wsun26/ece445/CAD/Capture.PNG

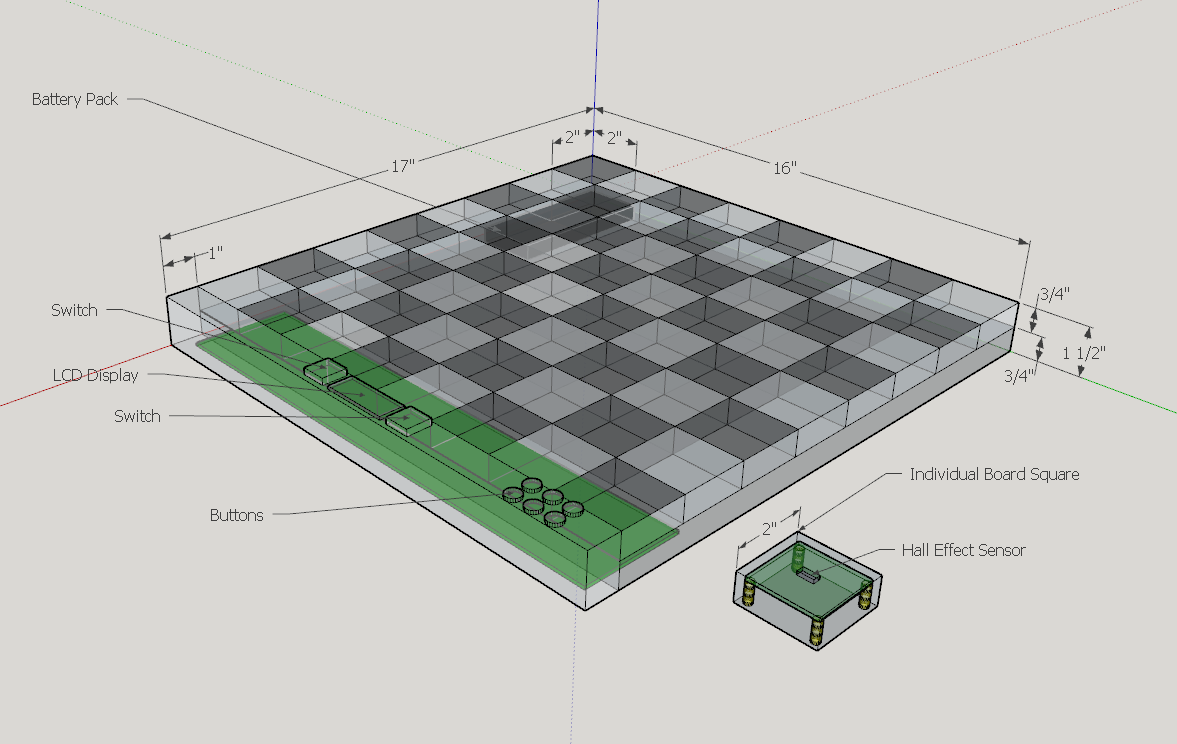
CAD/Capture.PNG
