wsun26/ece445/CAD/chess_board.PNG

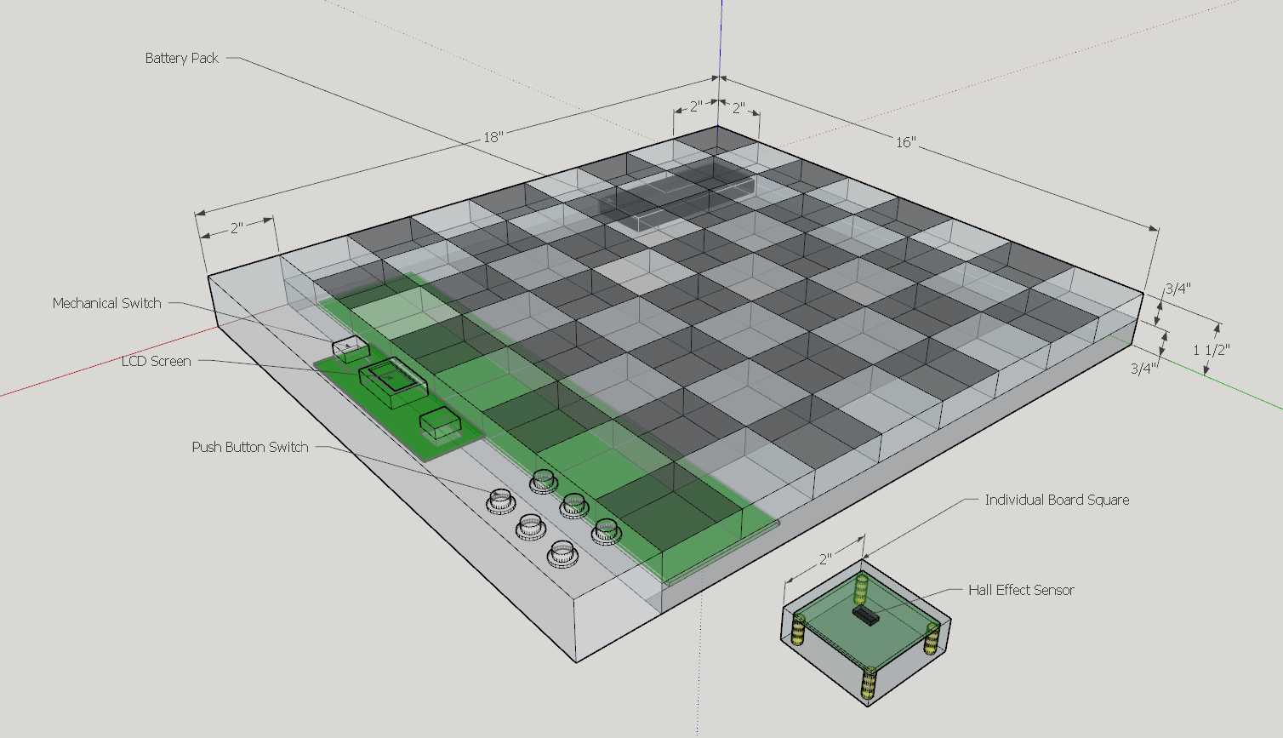
CAD/chess_board.PNG
