wsun26/ece445/CAD/chess_piece_overview.PNG

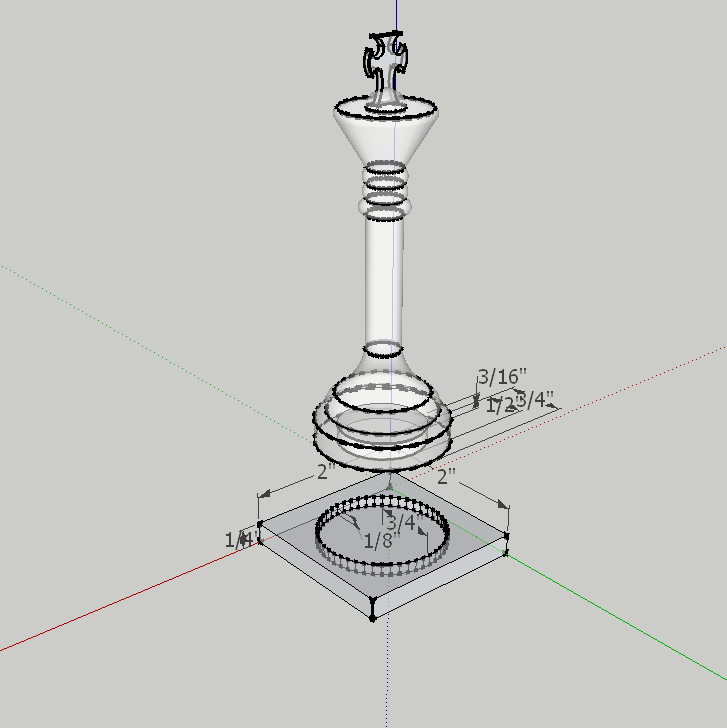
CAD/chess_piece_overview.PNG
