wsun26/ece445/CAD/chess_UI.PNG

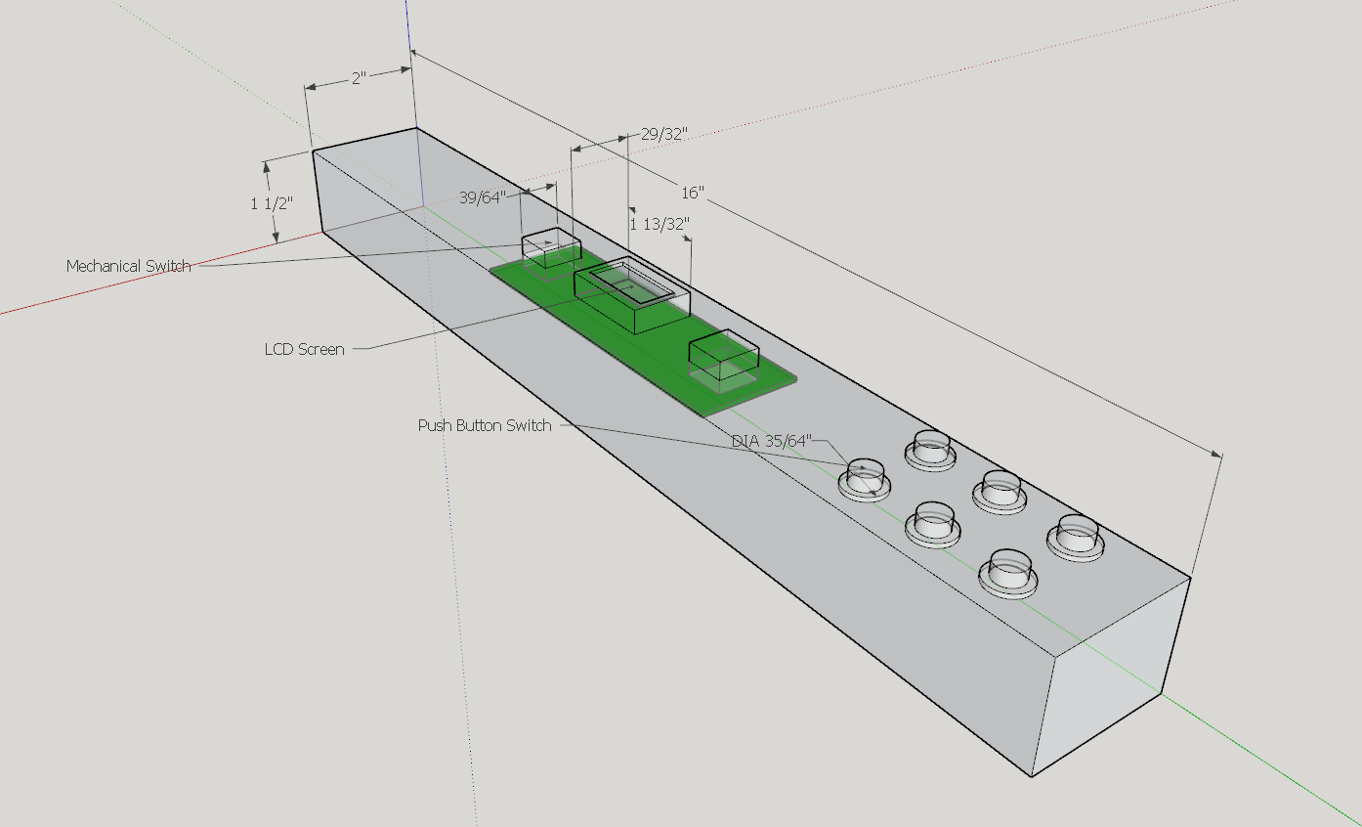
CAD/chess_UI.PNG
