wsun26/ece445/cost_analysis.xlsx

 | prototype (price per item) | Quantity used | prototype (total cost) | bulk (price per item) | bulk (total cost)
Body | 20 | 1 | 20 | 5 | 5
Battery (2.6 Ah 3.7V Li-ion) | 5.95 | 2 | 11.9 | 5.95 | 11.9
Magnet (N42 1"x1/32") | 0.58 | 74 | 42.92 | 0.48 | 35.52
Battery Management IC (MCP-73831T-2ACIOT) | 0.6 | 1 | 0.6 | 0.42 | 0.42
LDO Voltage Regulator (TPS75533KTTT) | 6.1 | 1 | 6.1 | 3.2 | 3.2
Momentary Push Button | 0.536 | 6 | 3.216 | 0.536 | 3.216
Mechanical Switch | 1 | 2 | 2 | 0.5 | 1
8-bit SR (Mouser; SN74HC164NSR) | 0.39 | 24 | 9.36 | 0.108 | 2.592
Demultiplexer (MC74HC238ADR2G) | 0.281 | 1 | 0.281 | 0.078 | 0.078
Bronze Acrylic (1/8") | 0.098 | 32 | 3.136 | 0.098 | 3.136
White Acrylic (1/8") | 0.093 | 32 | 2.976 | 0.093 | 2.976
LCD Display (0208AZ-FSW-GBW-33V3) | 9.8 | 1 | 9.8 | 7.056 | 7.056
Bluetooth Module (HC-06) | 8.99 | 1 | 8.99 | 8.99 | 8.99
Microcontroller (MSP430FR5962IZVWR) | 6.23 | 1 | 6.23 | 3.4 | 3.4
ADC (MAX11603EEE+) | 1.73 | 8 | 13.84 | 1.63 | 13.04
LED (5mm RGB 4 pin) | 0.0896 | 64 | 5.7344 | 0.0896 | 5.7344
Hall Effect Sensor (DRV5053VAQDBZR) | 0.736 | 64 | 47.104 | 0.349 | 22.336
PCB (1"x1" single layer) | 0.24 | 64 | 15.36 | 0.0435 | 2.784
PCB (4"x4" two layer) | 5.6 | 1 | 5.6 | 0.865 | 0.865
Chess Set (1 1/4" base) | 5 | 1 | 5 | 5 | 5
Total |  |  | 220.1474 |  | 138.2434
