wsun26/ece445/(list of files, cad)

Other CAD files:
CAD/UI_layout.skp
CAD/attempt_1.skp
CAD/board_sketchup.skp
CAD/king.skp
