wsun26/ece445/CAD/chess_piece_measurement.PNG

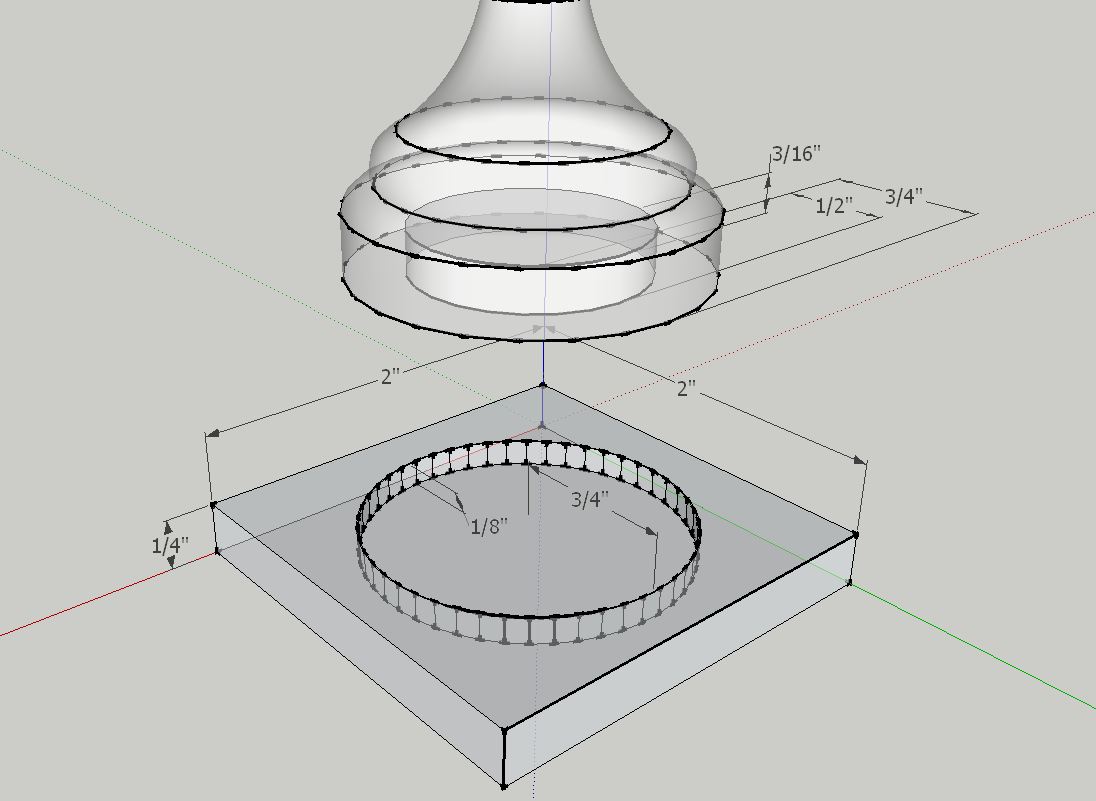
CAD/chess_piece_measurement.PNG
