wsun26/ece445/CAD/chess_piece_measurement_with_sensor.PNG

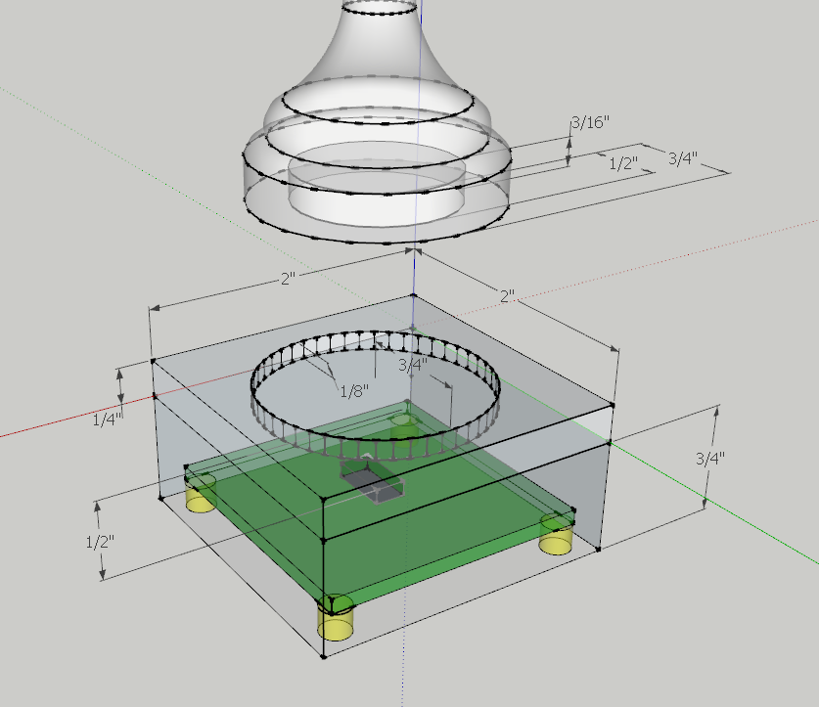
CAD/chess_piece_measurement_with_sensor.PNG
