wsun26/ece445/sensor_board/SensorInterface.brd

## EAGLE design sensor_board/SensorInterface.brd (2019-05-03)

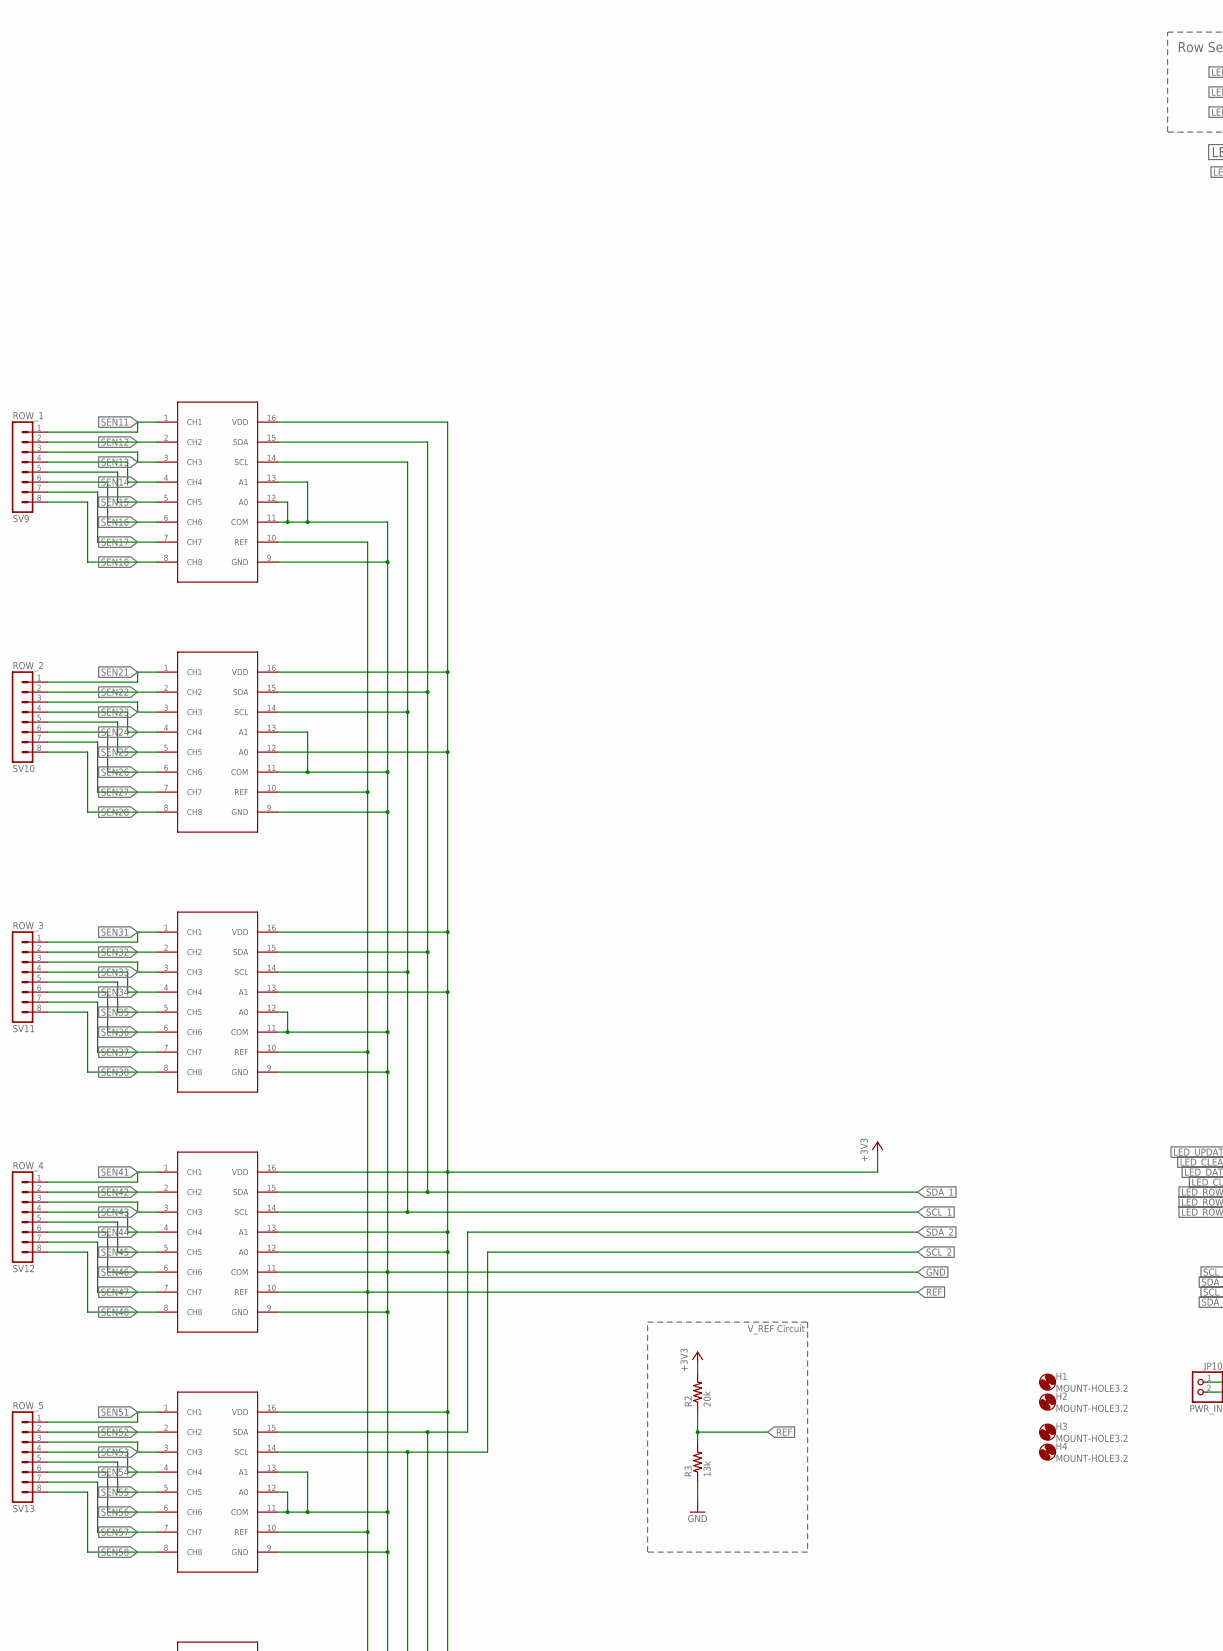
[picture p7: schematic SensorInterface.sch, part in row 1, column 1]

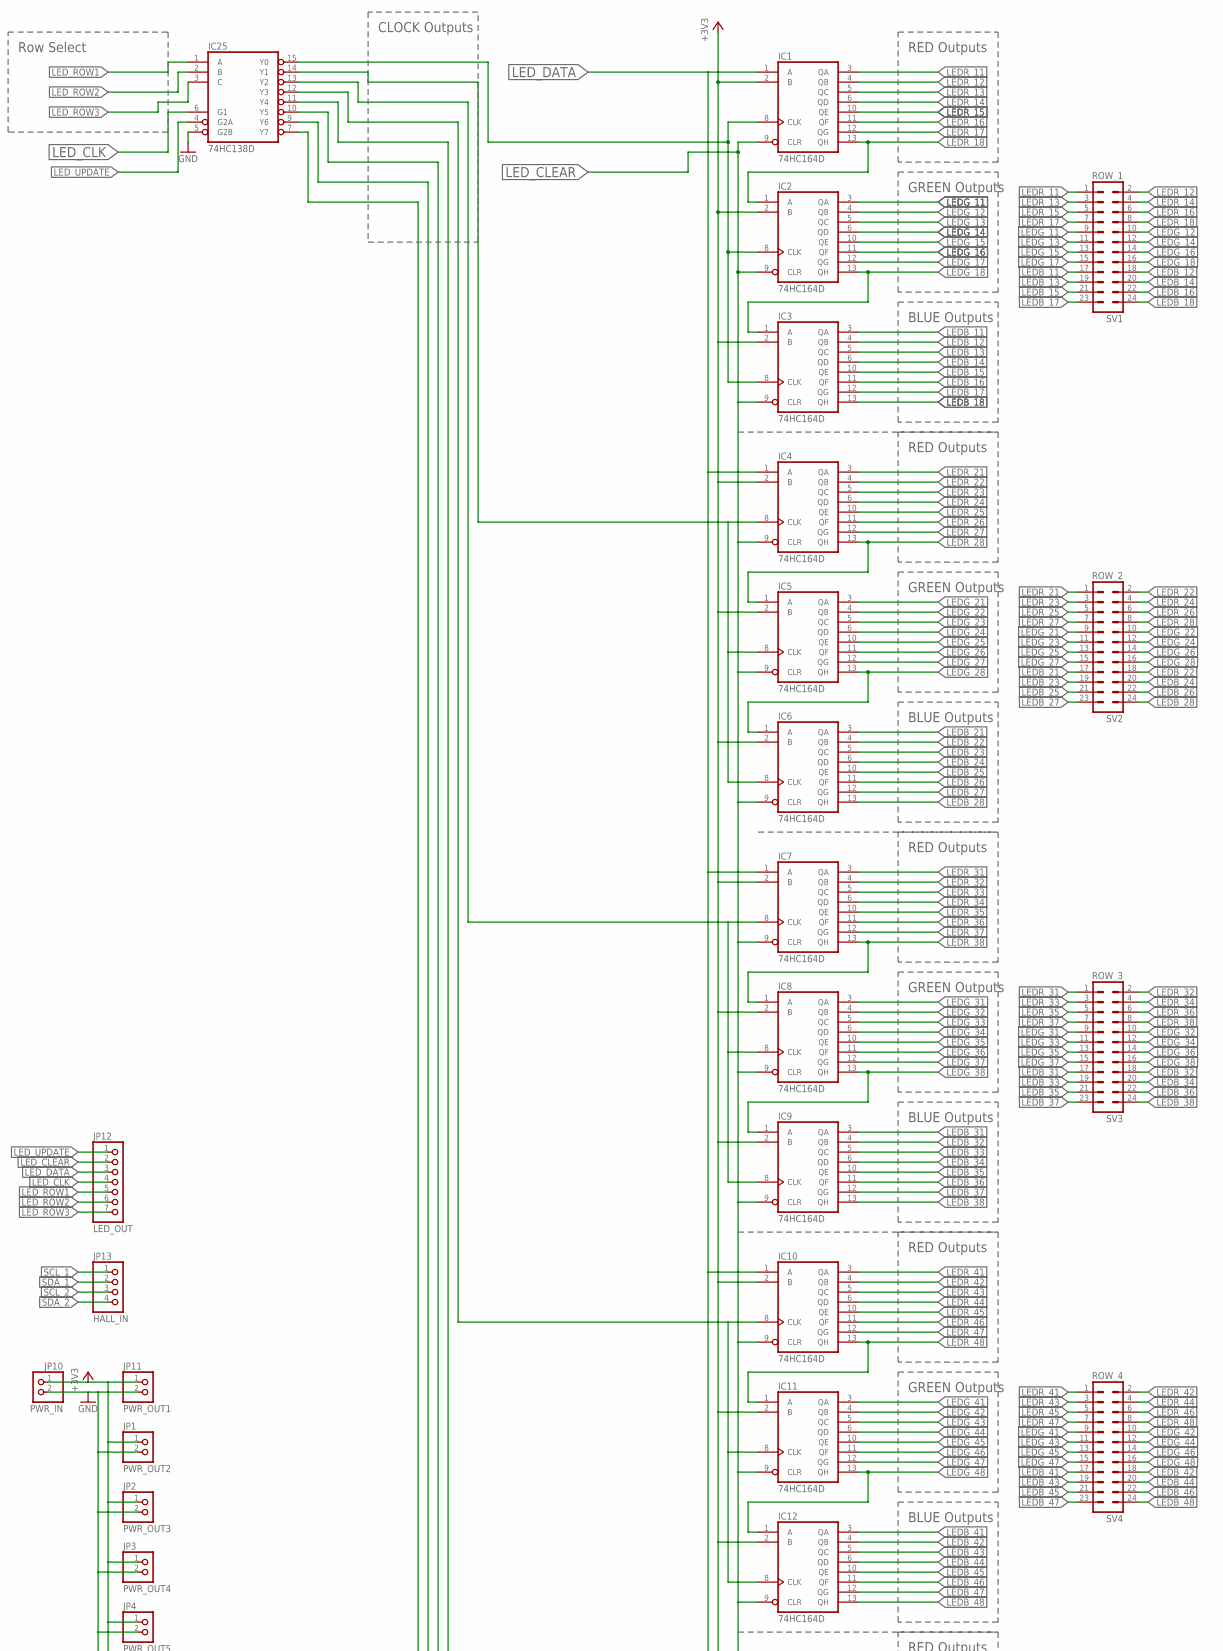
[picture p8: schematic SensorInterface.sch, part in row 1, column 2]

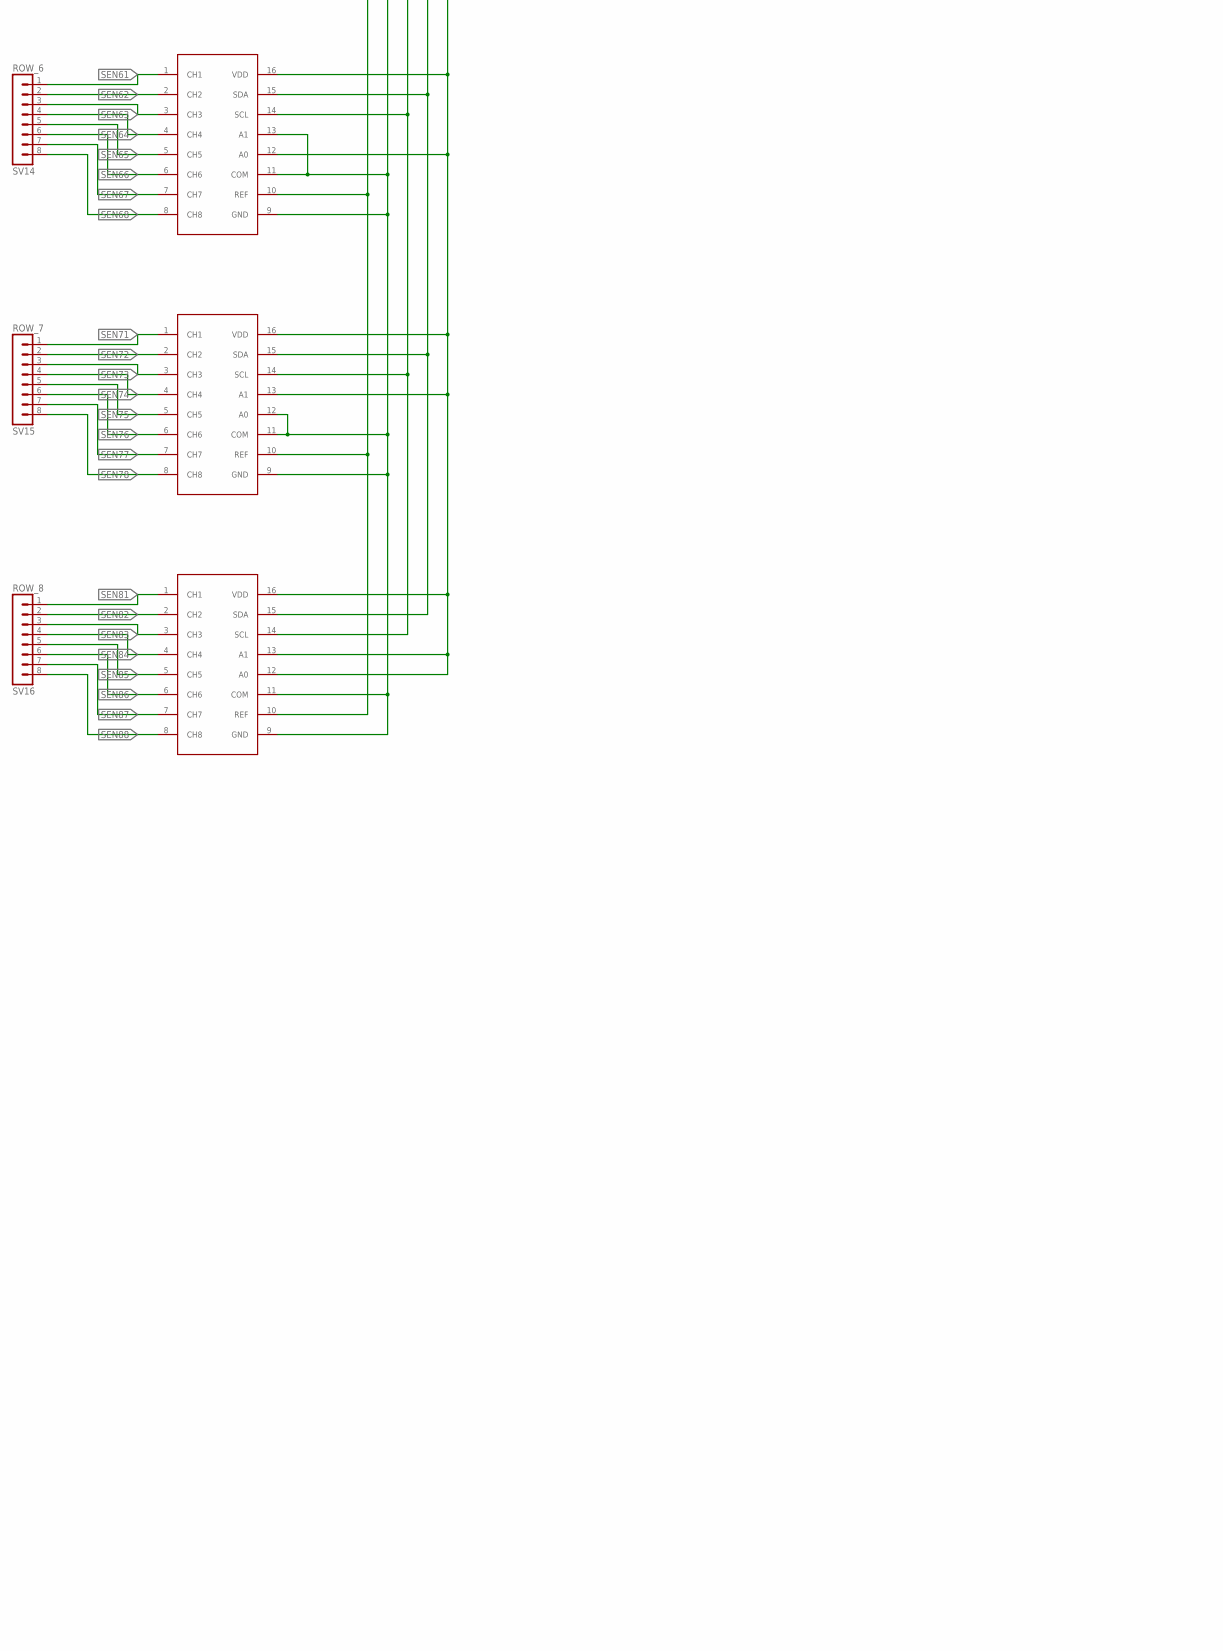
[picture p9: schematic SensorInterface.sch, part in row 2, column 1]

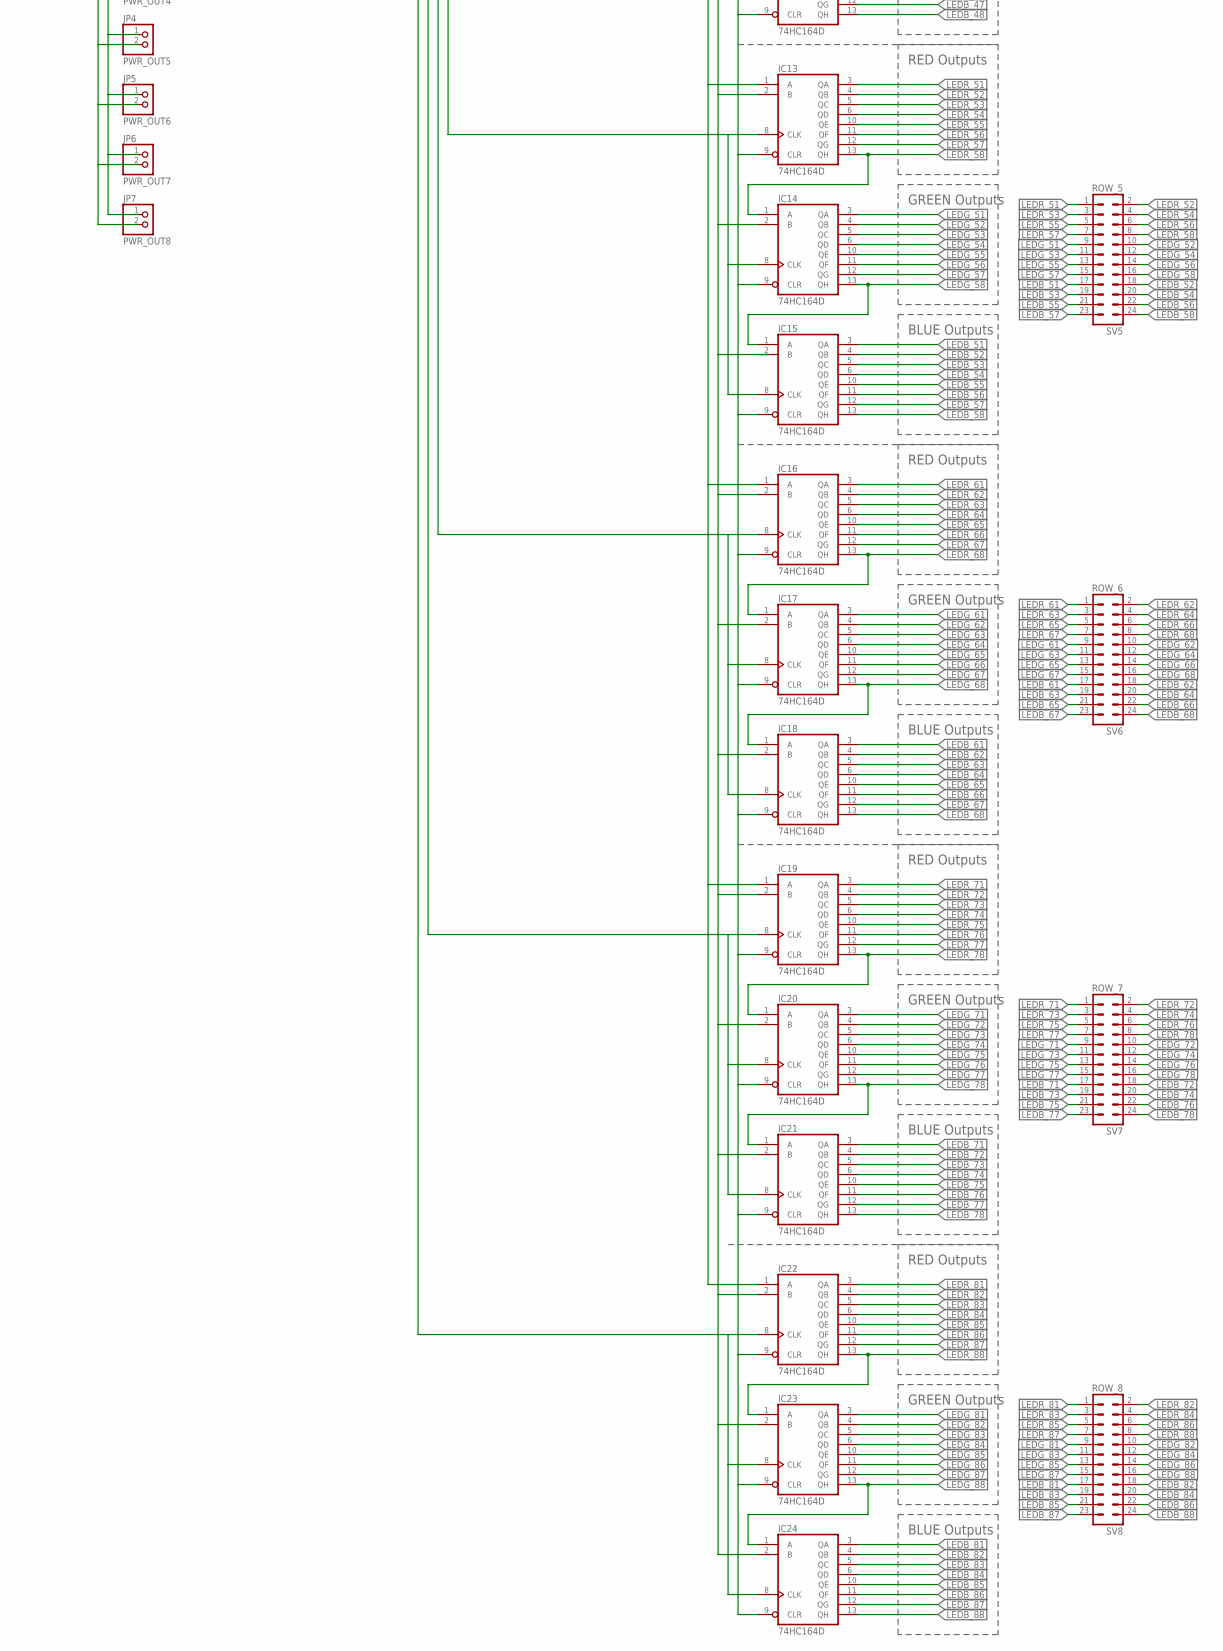
[picture p10: schematic SensorInterface.sch, part in row 2, column 2]

Parts:
H1, H2, H3, H4: MOUNT-HOLE3.2; 3,2
IC1, IC2, IC3, IC4, IC5, IC6, IC7, IC8, IC9, IC10, IC11, IC12, IC13, IC14, IC15, IC16, IC17, IC18, IC19, IC20, IC21, IC22, IC23, IC24: 74HC164D; SO14
IC25: 74HC138D; SO16
JP1: PWR_OUT2; 1X02
JP2: PWR_OUT3; 1X02
JP3: PWR_OUT4; 1X02
JP4: PWR_OUT5; 1X02
JP5: PWR_OUT6; 1X02
JP6: PWR_OUT7; 1X02
JP7: PWR_OUT8; 1X02
JP10: PWR_IN; 1X02
JP11: PWR_OUT1; 1X02
JP12: LED_OUT; 1X07
JP13: HALL_IN; 1X04
R2: 20k; R0603
R3: 13k; R0603
SV1: ROW_1; MA12-2
SV2: ROW_2; MA12-2
SV3: ROW_3; MA12-2
SV4: ROW_4; MA12-2
SV5: ROW_5; MA12-2
SV6: ROW_6; MA12-2
SV7: ROW_7; MA12-2
SV8: ROW_8; MA12-2
SV9: ROW_1; MA08-1
SV10: ROW_2; MA08-1
SV11: ROW_3; MA08-1
SV12: ROW_4; MA08-1
SV13: ROW_5; MA08-1
SV14: ROW_6; MA08-1
SV15: ROW_7; MA08-1
SV16: ROW_8; MA08-1
U$1, U$2, U$3, U$4, U$5, U$6, U$7, U$8: NCD9830; TSSOP16

Connections:
+3V3: IC1.2 (B), IC2.2 (B), IC3.2 (B), IC4.2 (B), IC5.2 (B), IC6.2 (B), IC7.2 (B), IC8.2 (B), IC9.2 (B), IC10.2 (B), IC11.2 (B), IC12.2 (B), IC13.2 (B), IC14.2 (B), IC16.2 (B), IC17.2 (B), IC18.2 (B), IC19.2 (B), IC20.2 (B), IC21.2 (B), IC22.2 (B), IC23.2 (B), IC24.2 (B), JP1.1, JP2.1, JP3.1, JP4.1, JP5.1, JP6.1, JP7.1, JP10.1, JP11.1, R2.2, U$1.12 (A0), U$1.16 (VDD), U$2.13 (A1), U$2.16 (VDD), U$3.12 (A0), U$3.13 (A1), U$3.16 (VDD), U$4.16 (VDD), U$5.12 (A0), U$5.16 (VDD), U$6.13 (A1), U$6.16 (VDD), U$7.16 (VDD), U$8.12 (A0), U$8.13 (A1), U$8.16 (VDD)
CLK: IC19.8 (CLK), IC20.8 (CLK), IC21.8 (CLK), IC25.9 (Y6)
GND: IC1.7 (GND), IC2.7 (GND), IC3.7 (GND), IC4.7 (GND), IC5.7 (GND), IC6.7 (GND), IC7.7 (GND), IC8.7 (GND), IC9.7 (GND), IC10.7 (GND), IC11.7 (GND), IC12.7 (GND), IC13.7 (GND), IC14.7 (GND), IC15.7 (GND), IC16.7 (GND), IC17.7 (GND), IC18.7 (GND), IC19.7 (GND), IC20.7 (GND), IC21.7 (GND), IC22.7 (GND), IC23.7 (GND), IC24.7 (GND), IC25.5 (G2B), IC25.8 (GND), JP1.2, JP2.2, JP3.2, JP4.2, JP5.2, JP6.2, JP7.2, JP10.2, JP11.2, R3.1, U$1.9 (GND), U$1.11 (COM), U$1.13 (A1), U$2.9 (GND), U$2.11 (COM), U$2.12 (A0), U$3.9 (GND), U$3.11 (COM), U$4.9 (GND), U$4.11 (COM), U$4.12 (A0), U$4.13 (A1), U$5.9 (GND), U$5.11 (COM), U$5.13 (A1), U$6.9 (GND), U$6.11 (COM), U$6.12 (A0), U$7.9 (GND), U$7.11 (COM), U$7.12 (A0), U$7.13 (A1), U$8.9 (GND), U$8.11 (COM)
LEDB_11: IC3.3 (QA), SV1.17
LEDB_12: IC3.4 (QB), SV1.18
LEDB_13: IC3.5 (QC), SV1.19
LEDB_14: IC3.6 (QD), SV1.20
LEDB_15: IC3.10 (QE), SV1.21
LEDB_16: IC3.11 (QF), SV1.22
LEDB_17: IC3.12 (QG), SV1.23
LEDB_18: IC3.13 (QH), SV1.24
LEDB_21: IC6.3 (QA), SV2.17
LEDB_22: IC6.4 (QB), SV2.18
LEDB_23: IC6.5 (QC), SV2.19
LEDB_24: IC6.6 (QD), SV2.20
LEDB_25: IC6.10 (QE), SV2.21
LEDB_26: IC6.11 (QF), SV2.22
LEDB_27: IC6.12 (QG), SV2.23
LEDB_28: IC6.13 (QH), SV2.24
LEDB_31: IC9.3 (QA), SV3.17
LEDB_32: IC9.4 (QB), SV3.18
LEDB_33: IC9.5 (QC), SV3.19
LEDB_34: IC9.6 (QD), SV3.20
LEDB_35: IC9.10 (QE), SV3.21
LEDB_36: IC9.11 (QF), SV3.22
LEDB_37: IC9.12 (QG), SV3.23
LEDB_38: IC9.13 (QH), SV3.24
LEDB_41: IC12.3 (QA), SV4.17
LEDB_42: IC12.4 (QB), SV4.18
LEDB_43: IC12.5 (QC), SV4.19
LEDB_44: IC12.6 (QD), SV4.20
LEDB_45: IC12.10 (QE), SV4.21
LEDB_46: IC12.11 (QF), SV4.22
LEDB_47: IC12.12 (QG), SV4.23
LEDB_48: IC12.13 (QH), SV4.24
LEDB_51: IC15.3 (QA), SV5.17
LEDB_52: IC15.4 (QB), SV5.18
LEDB_53: IC15.5 (QC), SV5.19
LEDB_54: IC15.6 (QD), SV5.20
LEDB_55: IC15.10 (QE), SV5.21
LEDB_56: IC15.11 (QF), SV5.22
LEDB_57: IC15.12 (QG), SV5.23
LEDB_58: IC15.13 (QH), SV5.24
LEDB_61: IC18.3 (QA), SV6.17
LEDB_62: IC18.4 (QB), SV6.18
LEDB_63: IC18.5 (QC), SV6.19
LEDB_64: IC18.6 (QD), SV6.20
LEDB_65: IC18.10 (QE), SV6.21
LEDB_66: IC18.11 (QF), SV6.22
LEDB_67: IC18.12 (QG), SV6.23
LEDB_68: IC18.13 (QH), SV6.24
LEDB_71: IC21.3 (QA), SV7.17
LEDB_72: IC21.4 (QB), SV7.18
LEDB_73: IC21.5 (QC), SV7.19
LEDB_74: IC21.6 (QD), SV7.20
LEDB_75: IC21.10 (QE), SV7.21
LEDB_76: IC21.11 (QF), SV7.22
LEDB_77: IC21.12 (QG), SV7.23
LEDB_78: IC21.13 (QH), SV7.24
LEDB_81: IC24.3 (QA), SV8.17
LEDB_82: IC24.4 (QB), SV8.18
LEDB_83: IC24.5 (QC), SV8.19
LEDB_84: IC24.6 (QD), SV8.20
LEDB_85: IC24.10 (QE), SV8.21
LEDB_86: IC24.11 (QF), SV8.22
LEDB_87: IC24.12 (QG), SV8.23
LEDB_88: IC24.13 (QH), SV8.24
LEDG_11: IC2.3 (QA), SV1.9
LEDG_12: IC2.4 (QB), SV1.10
LEDG_13: IC2.5 (QC), SV1.11
LEDG_14: IC2.6 (QD), SV1.12
LEDG_15: IC2.10 (QE), SV1.13
LEDG_16: IC2.11 (QF), SV1.14
LEDG_17: IC2.12 (QG), SV1.15
LEDG_18: IC2.13 (QH), IC3.1 (A), SV1.16
LEDG_21: IC5.3 (QA), SV2.9
LEDG_22: IC5.4 (QB), SV2.10
LEDG_23: IC5.5 (QC), SV2.11
LEDG_24: IC5.6 (QD), SV2.12
LEDG_25: IC5.10 (QE), SV2.13
LEDG_26: IC5.11 (QF), SV2.14
LEDG_27: IC5.12 (QG), SV2.15
LEDG_28: IC5.13 (QH), IC6.1 (A), SV2.16
LEDG_31: IC8.3 (QA), SV3.9
LEDG_32: IC8.4 (QB), SV3.10
LEDG_33: IC8.5 (QC), SV3.11
LEDG_34: IC8.6 (QD), SV3.12
LEDG_35: IC8.10 (QE), SV3.13
LEDG_36: IC8.11 (QF), SV3.14
LEDG_37: IC8.12 (QG), SV3.15
LEDG_38: IC8.13 (QH), IC9.1 (A), SV3.16
LEDG_41: IC11.3 (QA), SV4.9
LEDG_42: IC11.4 (QB), SV4.10
LEDG_43: IC11.5 (QC), SV4.11
LEDG_44: IC11.6 (QD), SV4.12
LEDG_45: IC11.10 (QE), SV4.13
LEDG_46: IC11.11 (QF), SV4.14
LEDG_47: IC11.12 (QG), SV4.15
LEDG_48: IC11.13 (QH), IC12.1 (A), SV4.16
LEDG_51: IC14.3 (QA), SV5.9
LEDG_52: IC14.4 (QB), SV5.10
LEDG_53: IC14.5 (QC), SV5.11
LEDG_54: IC14.6 (QD), SV5.12
LEDG_55: IC14.10 (QE), SV5.13
LEDG_56: IC14.11 (QF), SV5.14
LEDG_57: IC14.12 (QG), SV5.15
LEDG_58: IC14.13 (QH), IC15.1 (A), SV5.16
LEDG_61: IC17.3 (QA), SV6.9
LEDG_62: IC17.4 (QB), SV6.10
LEDG_63: IC17.5 (QC), SV6.11
LEDG_64: IC17.6 (QD), SV6.12
LEDG_65: IC17.10 (QE), SV6.13
LEDG_66: IC17.11 (QF), SV6.14
LEDG_67: IC17.12 (QG), SV6.15
LEDG_68: IC17.13 (QH), IC18.1 (A), SV6.16
LEDG_71: IC20.3 (QA), SV7.9
LEDG_72: IC20.4 (QB), SV7.10
LEDG_73: IC20.5 (QC), SV7.11
LEDG_74: IC20.6 (QD), SV7.12
LEDG_75: IC20.10 (QE), SV7.13
LEDG_76: IC20.11 (QF), SV7.14
LEDG_77: IC20.12 (QG), SV7.15
LEDG_78: IC20.13 (QH), IC21.1 (A), SV7.16
LEDG_81: IC23.3 (QA), SV8.9
LEDG_82: IC23.4 (QB), SV8.10
LEDG_83: IC23.5 (QC), SV8.11
LEDG_84: IC23.6 (QD), SV8.12
LEDG_85: IC23.10 (QE), SV8.13
LEDG_86: IC23.11 (QF), SV8.14
LEDG_87: IC23.12 (QG), SV8.15
LEDG_88: IC23.13 (QH), IC24.1 (A), SV8.16
LEDR_11: IC1.3 (QA), SV1.1
LEDR_12: IC1.4 (QB), SV1.2
LEDR_13: IC1.5 (QC), SV1.3
LEDR_14: IC1.6 (QD), SV1.4
LEDR_15: IC1.10 (QE), SV1.5
LEDR_16: IC1.11 (QF), SV1.6
LEDR_17: IC1.12 (QG), SV1.7
LEDR_18: IC1.13 (QH), IC2.1 (A), SV1.8
LEDR_21: IC4.3 (QA), SV2.1
LEDR_22: IC4.4 (QB), SV2.2
LEDR_23: IC4.5 (QC), SV2.3
LEDR_24: IC4.6 (QD), SV2.4
LEDR_25: IC4.10 (QE), SV2.5
LEDR_26: IC4.11 (QF), SV2.6
LEDR_27: IC4.12 (QG), SV2.7
LEDR_28: IC4.13 (QH), IC5.1 (A), SV2.8
LEDR_31: IC7.3 (QA), SV3.1
LEDR_32: IC7.4 (QB), SV3.2
LEDR_33: IC7.5 (QC), SV3.3
LEDR_34: IC7.6 (QD), SV3.4
LEDR_35: IC7.10 (QE), SV3.5
LEDR_36: IC7.11 (QF), SV3.6
LEDR_37: IC7.12 (QG), SV3.7
LEDR_38: IC7.13 (QH), IC8.1 (A), SV3.8
LEDR_41: IC10.3 (QA), SV4.1
LEDR_42: IC10.4 (QB), SV4.2
LEDR_43: IC10.5 (QC), SV4.3
LEDR_44: IC10.6 (QD), SV4.4
LEDR_45: IC10.10 (QE), SV4.5
LEDR_46: IC10.11 (QF), SV4.6
LEDR_47: IC10.12 (QG), SV4.7
LEDR_48: IC10.13 (QH), IC11.1 (A), SV4.8
LEDR_51: IC13.3 (QA), SV5.1
LEDR_52: IC13.4 (QB), SV5.2
LEDR_53: IC13.5 (QC), SV5.3
LEDR_54: IC13.6 (QD), SV5.4
LEDR_55: IC13.10 (QE), SV5.5
LEDR_56: IC13.11 (QF), SV5.6
LEDR_57: IC13.12 (QG), SV5.7
LEDR_58: IC13.13 (QH), IC14.1 (A), SV5.8
LEDR_61: IC16.3 (QA), SV6.1
LEDR_62: IC16.4 (QB), SV6.2
LEDR_63: IC16.5 (QC), SV6.3
LEDR_64: IC16.6 (QD), SV6.4
LEDR_65: IC16.10 (QE), SV6.5
LEDR_66: IC16.11 (QF), SV6.6
LEDR_67: IC16.12 (QG), SV6.7
LEDR_68: IC16.13 (QH), IC17.1 (A), SV6.8
LEDR_71: IC19.3 (QA), SV7.1
LEDR_72: IC19.4 (QB), SV7.2
LEDR_73: IC19.5 (QC), SV7.3
LEDR_74: IC19.6 (QD), SV7.4
LEDR_75: IC19.10 (QE), SV7.5
LEDR_76: IC19.11 (QF), SV7.6
LEDR_77: IC19.12 (QG), SV7.7
LEDR_78: IC19.13 (QH), IC20.1 (A), SV7.8
LEDR_81: IC22.3 (QA), SV8.1
LEDR_82: IC22.4 (QB), SV8.2
LEDR_83: IC22.5 (QC), SV8.3
LEDR_84: IC22.6 (QD), SV8.4
LEDR_85: IC22.10 (QE), SV8.5
LEDR_86: IC22.11 (QF), SV8.6
LEDR_87: IC22.12 (QG), SV8.7
LEDR_88: IC22.13 (QH), IC23.1 (A), SV8.8
LED_CLEAR: IC1.9 (CLR), IC2.9 (CLR), IC3.9 (CLR), IC4.9 (CLR), IC5.9 (CLR), IC6.9 (CLR), IC7.9 (CLR), IC8.9 (CLR), IC9.9 (CLR), IC10.9 (CLR), IC11.9 (CLR), IC12.9 (CLR), IC13.9 (CLR), IC14.9 (CLR), IC15.9 (CLR), IC16.9 (CLR), IC17.9 (CLR), IC18.9 (CLR), IC19.9 (CLR), IC20.9 (CLR), IC21.9 (CLR), IC22.9 (CLR), IC23.9 (CLR), IC24.9 (CLR), JP12.2
LED_CLK: IC25.6 (G1), JP12.4
LED_DATA: IC1.1 (A), IC4.1 (A), IC7.1 (A), IC10.1 (A), IC13.1 (A), IC16.1 (A), IC19.1 (A), IC22.1 (A), JP12.3
LED_ROW1: IC25.1 (A), JP12.5
LED_ROW2: IC25.2 (B), JP12.6
LED_ROW3: IC25.3 (C), JP12.7
LED_UPDATE: IC25.4 (G2A), JP12.1
unnamed: IC1.8 (CLK), IC2.8 (CLK), IC3.8 (CLK), IC25.15 (Y0)
unnamed: IC4.8 (CLK), IC5.8 (CLK), IC6.8 (CLK), IC25.14 (Y1)
unnamed: IC7.8 (CLK), IC8.8 (CLK), IC9.8 (CLK), IC25.13 (Y2)
unnamed: IC10.8 (CLK), IC11.8 (CLK), IC12.8 (CLK), IC25.12 (Y3)
unnamed: IC13.8 (CLK), IC14.8 (CLK), IC15.8 (CLK), IC25.11 (Y4)
unnamed: IC16.8 (CLK), IC17.8 (CLK), IC18.8 (CLK), IC25.10 (Y5)
unnamed: IC22.8 (CLK), IC23.8 (CLK), IC24.8 (CLK), IC25.7 (Y7)
REF: R2.1, R3.2, U$1.10 (REF), U$2.10 (REF), U$3.10 (REF), U$4.10 (REF), U$5.10 (REF), U$6.10 (REF), U$7.10 (REF), U$8.10 (REF)
SCL_1: JP13.1, U$1.14 (SCL), U$2.14 (SCL), U$3.14 (SCL), U$7.14 (SCL)
SCL_2: JP13.3, U$4.14 (SCL), U$5.14 (SCL), U$6.14 (SCL), U$8.14 (SCL)
SDA_1: JP13.2, U$1.15 (SDA), U$2.15 (SDA), U$3.15 (SDA), U$7.15 (SDA)
SDA_2: JP13.4, U$4.15 (SDA), U$5.15 (SDA), U$6.15 (SDA), U$8.15 (SDA)
SEN11: SV9.1, U$7.1 (CH1)
SEN12: SV9.2, U$7.2 (CH2)
SEN13: SV9.3, U$7.3 (CH3)
SEN14: SV9.4, U$7.4 (CH4)
SEN15: SV9.5, U$7.5 (CH5)
SEN16: SV9.6, U$7.6 (CH6)
SEN17: SV9.7, U$7.7 (CH7)
SEN18: SV9.8, U$7.8 (CH8)
SEN21: SV10.1
SEN22: SV10.2
SEN23: SV10.3
SEN24: SV10.4
SEN25: SV10.5
SEN26: SV10.6
SEN27: SV10.7
SEN28: SV10.8
SEN31: SV11.1
SEN32: SV11.2
SEN33: SV11.3
SEN34: SV11.4
SEN35: SV11.5
SEN36: SV11.6
SEN37: SV11.7
SEN38: SV11.8
SEN41: SV12.1
SEN42: SV12.2
SEN43: SV12.3
SEN44: SV12.4
SEN45: SV12.5
SEN46: SV12.6
SEN47: SV12.7
SEN48: SV12.8
SEN51: SV13.1
SEN52: SV13.2
SEN53: SV13.3
SEN54: SV13.4
SEN55: SV13.5
SEN56: SV13.6
SEN57: SV13.7
SEN58: SV13.8
SEN61: SV14.1
SEN62: SV14.2
SEN63: SV14.3
SEN64: SV14.4
SEN65: SV14.5
SEN66: SV14.6
SEN67: SV14.7
SEN68: SV14.8
SEN71: SV15.1
SEN72: SV15.2
SEN73: SV15.3
SEN74: SV15.4
SEN75: SV15.5
SEN76: SV15.6
SEN77: SV15.7
SEN78: SV15.8
SEN81: SV16.1
SEN82: SV16.2
SEN83: SV16.3
SEN84: SV16.4
SEN85: SV16.5
SEN86: SV16.6
SEN87: SV16.7
SEN88: SV16.8
VCC: IC1.14 (VCC), IC2.14 (VCC), IC3.14 (VCC), IC4.14 (VCC), IC5.14 (VCC), IC6.14 (VCC), IC7.14 (VCC), IC8.14 (VCC), IC9.14 (VCC), IC10.14 (VCC), IC11.14 (VCC), IC12.14 (VCC), IC13.14 (VCC), IC14.14 (VCC), IC15.14 (VCC), IC16.14 (VCC), IC17.14 (VCC), IC18.14 (VCC), IC19.14 (VCC), IC20.14 (VCC), IC21.14 (VCC), IC22.14 (VCC), IC23.14 (VCC), IC24.14 (VCC), IC25.16 (VCC)

Notes on the sheet:
V_REF Circuit
RED Outputs
GREEN Outputs
BLUE Outputs
CLOCK Outputs
Row Select

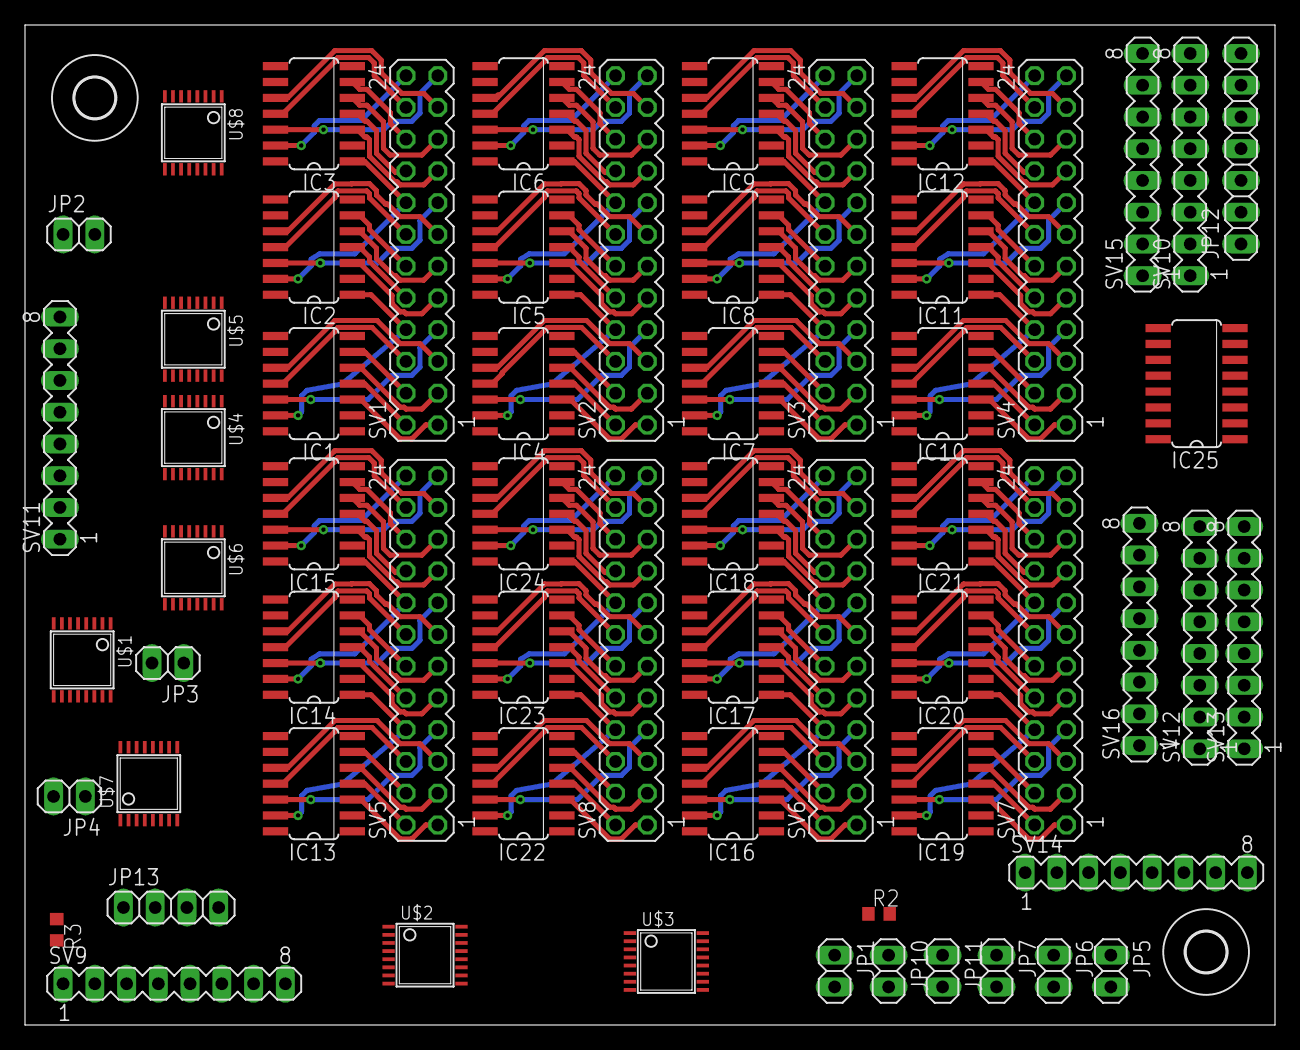
[picture p11: board SensorInterface.brd from above]

Board: 2 copper layers, 100.0 x 80.0 mm, 66 parts (0 on the bottom side), 223 nets.
