wsun26/ece445/control_board/ControlBoard.brd

## EAGLE design control_board/ControlBoard.brd (2019-05-03)

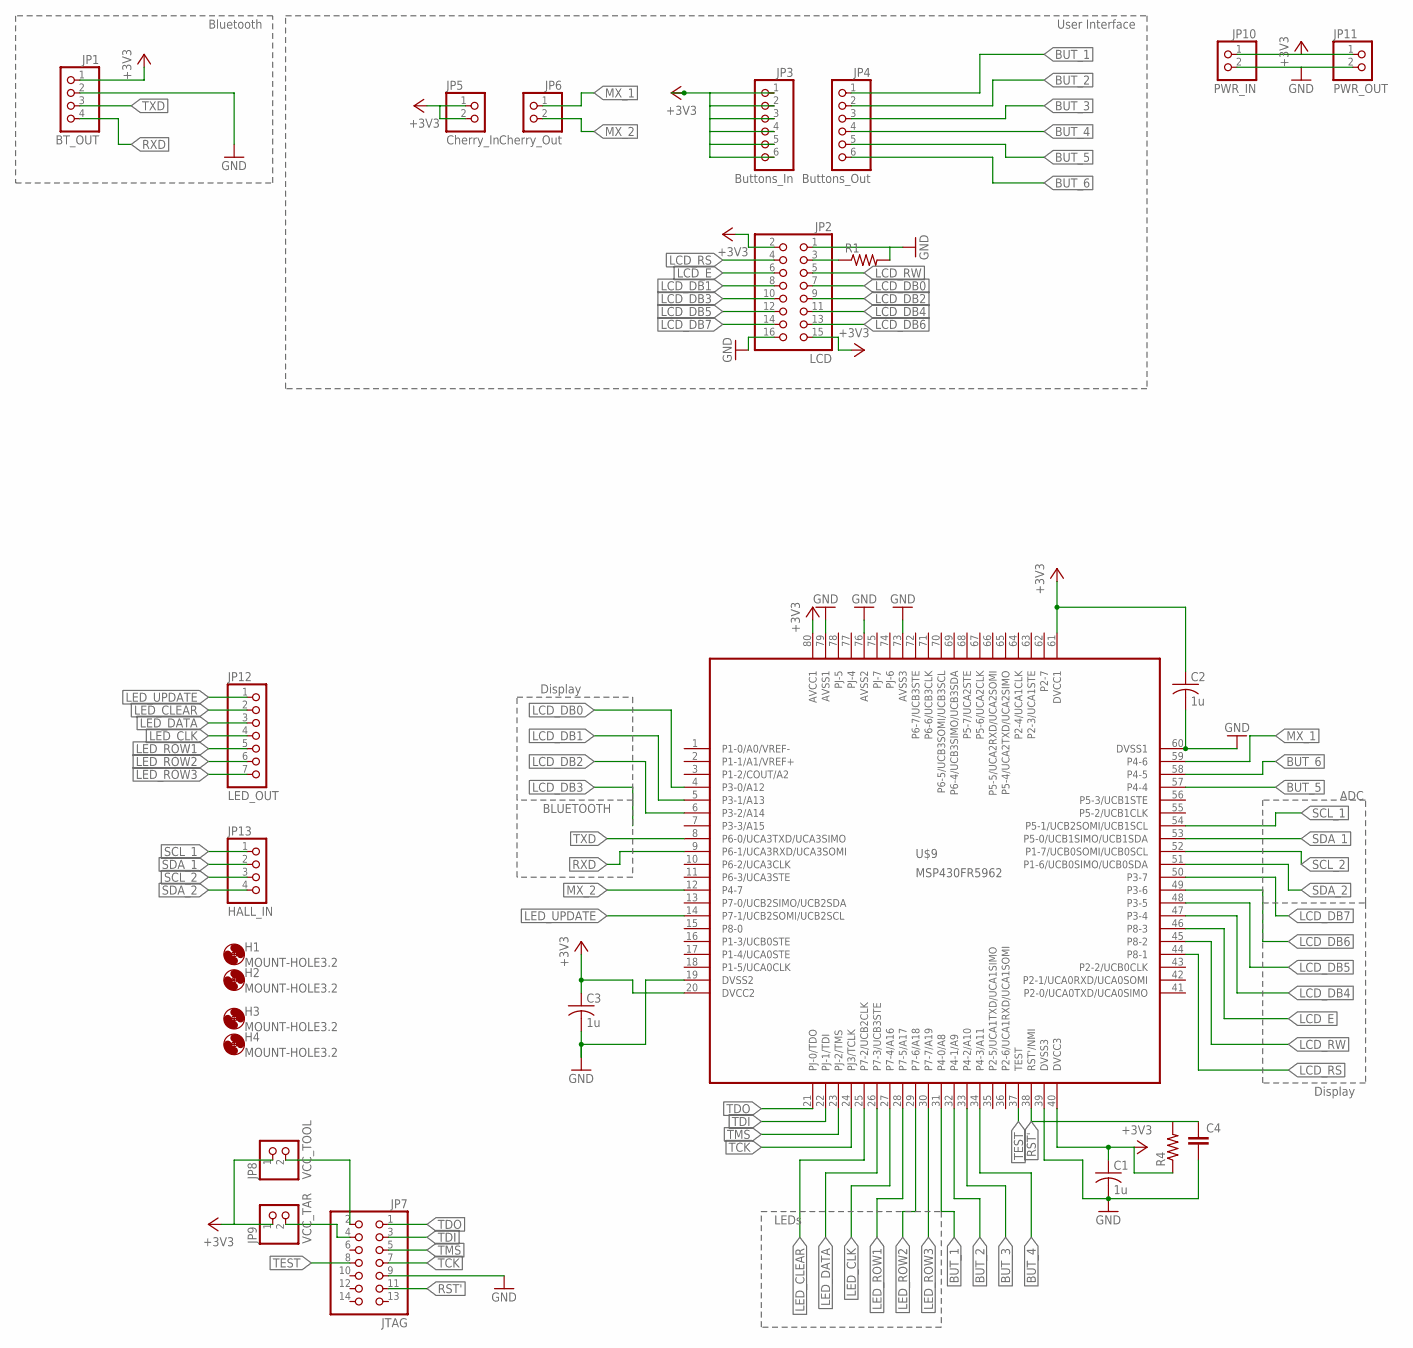
[picture p12: schematic ControlBoard.sch]

Parts:
C1, C2, C3: 1u; C0603
C4: C-EU025-025X050; C025-025X050
H1, H2, H3, H4: MOUNT-HOLE3.2; 3,2
JP1: BT_OUT; 1X04
JP2: LCD; 2X08
JP3: Buttons_In; 1X06
JP4: Buttons_Out; 1X06
JP5: Cherry_In; 1X02
JP6: Cherry_Out; 1X02
JP7: JTAG; 2X07
JP8: VCC_TOOL; 1X02
JP9: VCC_TAR; 1X02
JP10: PWR_IN; 1X02
JP11: PWR_OUT; 1X02
JP12: LED_OUT; 1X07
JP13: HALL_IN; 1X04
R1, R4: R-US_VMTA55; VMTA55
U$9: MSP430FR5962; LQFP80

Connections:
+3V3: C1.1, C2.1, C3.1, JP1.1, JP2.2, JP2.15, JP3.1, JP3.2, JP3.3, JP3.4, JP3.5, JP3.6, JP5.1, JP5.2, JP8.1, JP9.1, JP10.1, JP11.1, R4.1, U$9.20 (DVCC2), U$9.40 (DVCC3), U$9.61 (DVCC1), U$9.80 (AVCC1)
BUT_1: JP4.1, U$9.31 (P4-0/A8)
BUT_2: JP4.2, U$9.32 (P4-1/A9)
BUT_3: JP4.3, U$9.33 (P4-2/A10)
BUT_4: JP4.4, U$9.34 (P4-3/A11)
BUT_5: JP4.5, U$9.57 (P4-4)
BUT_6: JP4.6, U$9.58 (P4-5)
GND: C1.2, C2.2, C3.2, C4.2, JP1.2, JP2.1, JP2.16, JP7.9, JP10.2, JP11.2, R1.2, U$9.19 (DVSS2), U$9.39 (DVSS3), U$9.60 (DVSS1), U$9.73 (AVSS3), U$9.76 (AVSS2), U$9.79 (AVSS1)
LCD_DB0: JP2.7, U$9.4 (P3-0/A12)
LCD_DB1: JP2.8, U$9.5 (P3-1/A13)
LCD_DB2: JP2.9, U$9.6 (P3-2/A14)
LCD_DB3: JP2.10
LCD_DB4: JP2.11, U$9.47 (P3-4)
LCD_DB5: JP2.12, U$9.48 (P3-5)
LCD_DB6: JP2.13, U$9.49 (P3-6)
LCD_DB7: JP2.14, U$9.50 (P3-7)
LCD_E: JP2.6, U$9.46 (P8-3)
LCD_RS: JP2.4, U$9.44 (P8-1)
LCD_RW: JP2.5, U$9.45 (P8-2)
LED_CLEAR: JP12.2, U$9.25 (P7-2/UCB2CLK)
LED_CLK: JP12.4, U$9.27 (P7-4/A16)
LED_DATA: JP12.3, U$9.26 (P7-3/UCB3STE)
LED_ROW1: JP12.5, U$9.28 (P7-5/A17)
LED_ROW2: JP12.6, U$9.29 (P7-6/A18)
LED_ROW3: JP12.7, U$9.30 (P7-7/A19)
LED_UPDATE: JP12.1, U$9.14 (P7-1/UCB2SOMI/UCB2SCL)
MX_1: JP6.1, U$9.59 (P4-6)
MX_2: JP6.2, U$9.12 (P4-7)
unnamed: JP2.3, R1.1
unnamed: JP7.2, JP8.2
unnamed: JP7.4, JP9.2
P1-0/A0/VREF-: U$9.1 (P1-0/A0/VREF-)
PJ-5: U$9.78 (PJ-5)
RST': C4.1, JP7.11, R4.2, U$9.38 (RST'/NMI)
RXD: JP1.4, U$9.9 (P6-1/UCA3RXD/UCA3SOMI)
SCL_1: JP13.1, U$9.54 (P5-1/UCB2SOMI/UCB1SCL)
SCL_2: JP13.3, U$9.52 (P1-7/UCB0SOMI/UCB0SCL)
SDA_1: JP13.2, U$9.53 (P5-0/UCB1SIMO/UCB1SDA)
SDA_2: JP13.4, U$9.51 (P1-6/UCB0SIMO/UCB0SDA)
TCK: JP7.7, U$9.24 (PJ3/TCLK)
TDI: JP7.3, U$9.22 (PJ-1/TDI)
TDO: JP7.1, U$9.21 (PJ-0/TDO)
TEST: JP7.8, U$9.37 (TEST)
TMS: JP7.5, U$9.23 (PJ-2/TMS)
TXD: JP1.3, U$9.8 (P6-0/UCA3TXD/UCA3SIMO)

Notes on the sheet:
Bluetooth
User Interface
BLUETOOTH
ADC
Display
LEDs

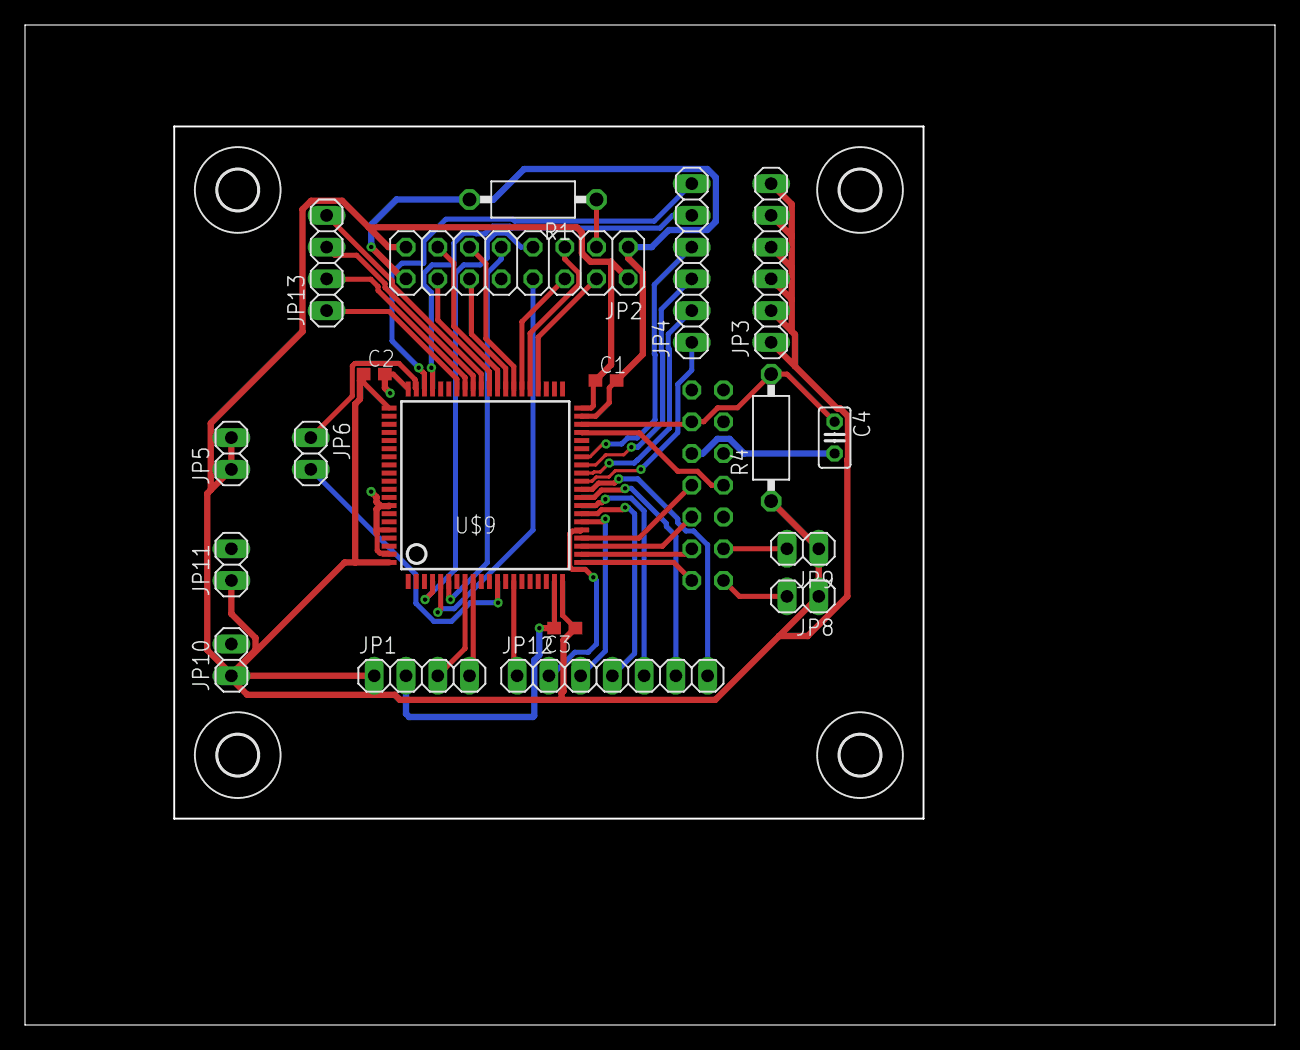
[picture p13: board ControlBoard.brd from above]

Board: 2 copper layers, 100.0 x 80.0 mm, 24 parts (1 on the bottom side), 42 nets.
